dahongx/Oracle-OS/design/references/28ec6939fcf05d6b30dbf5ed5ee75f74.jpg

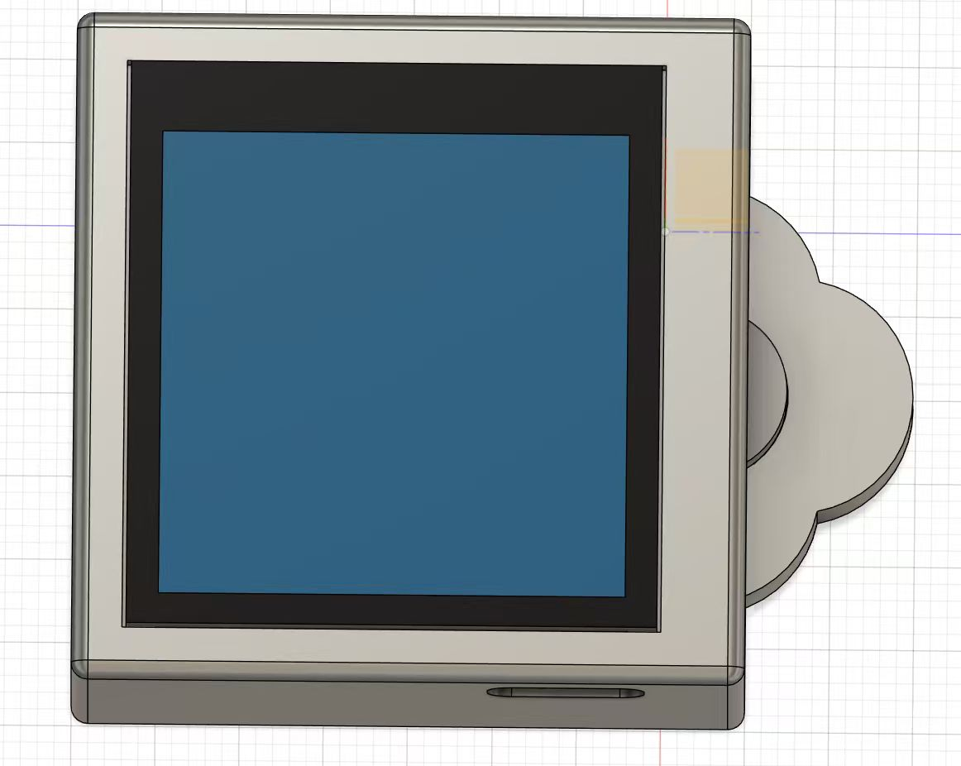
design/references/28ec6939fcf05d6b30dbf5ed5ee75f74.jpg
