dahongx/Oracle-OS/product/ChatGPT Image 2026年7月24日 02_36_47.png

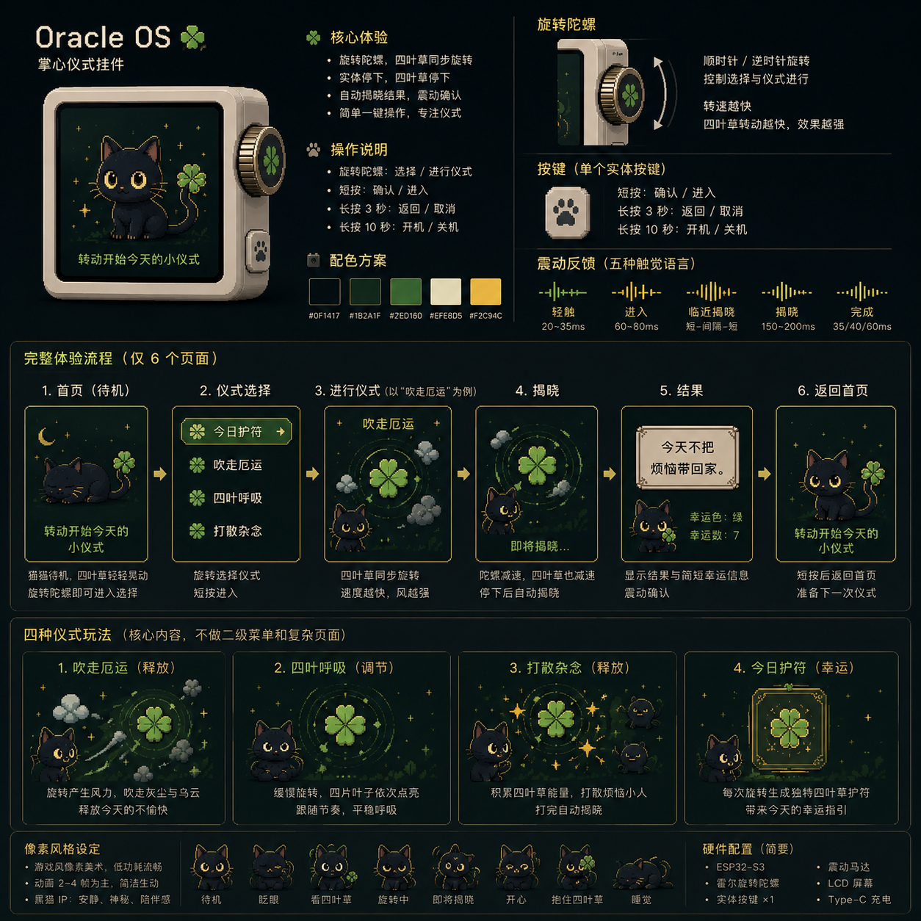
product/ChatGPT Image 2026年7月24日 02_36_47.png
