dahongx/Oracle-OS/design/references/oracle-os-mockup-v1.png

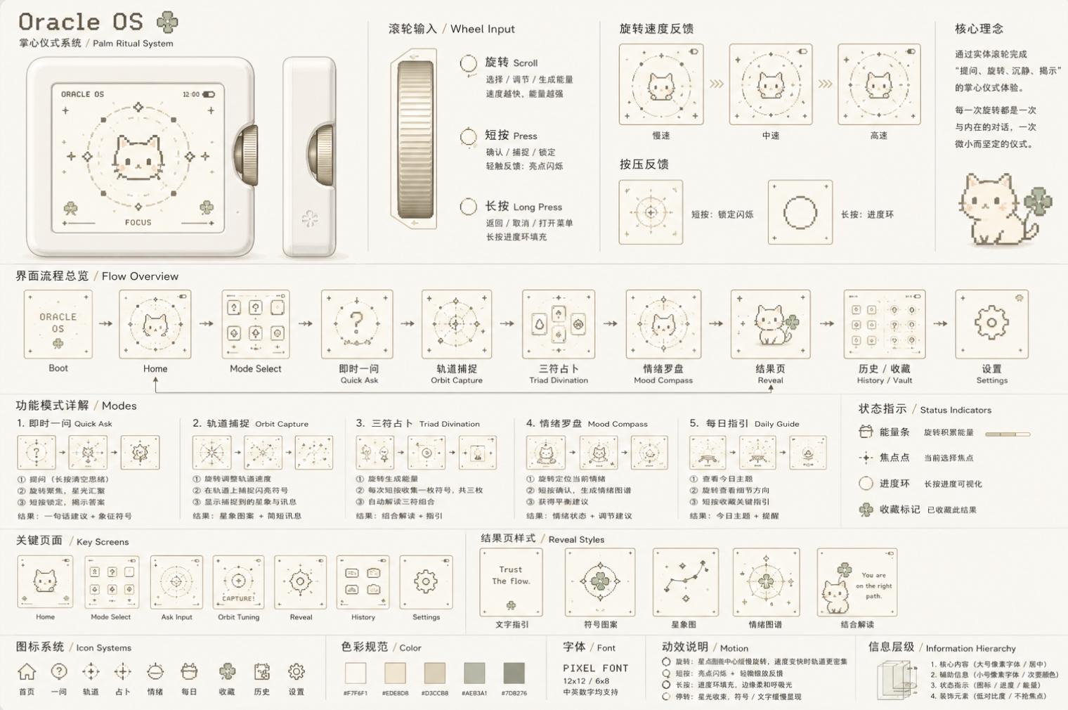
design/references/oracle-os-mockup-v1.png
