dahongx/Oracle-OS/firmware/esp32s3_knob_idf/tools/cat_preview.png

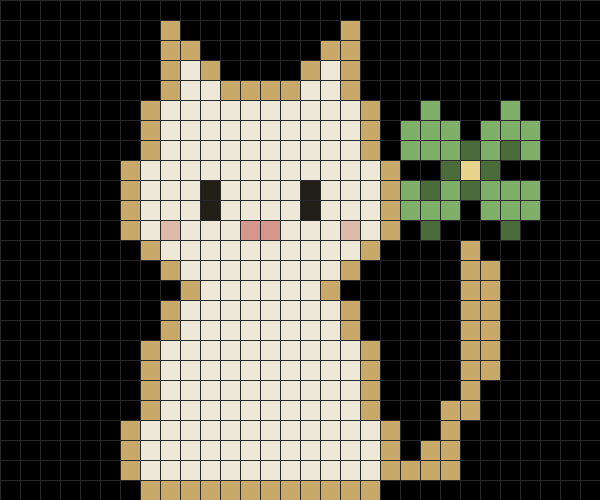
firmware/esp32s3_knob_idf/tools/cat_preview.png
