dahongx/Oracle-OS/firmware/esp32s3_knob_idf/tools/cat_sprites_preview.png

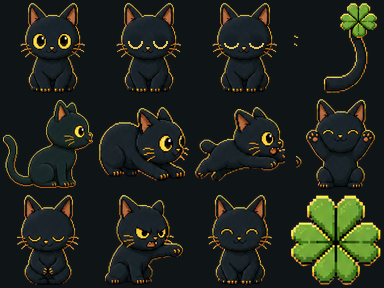
firmware/esp32s3_knob_idf/tools/cat_sprites_preview.png
