dahongx/Oracle-OS/hardware/doc/原理图截图/8ccac7d790108b71e4d9f03ce714a44b.png

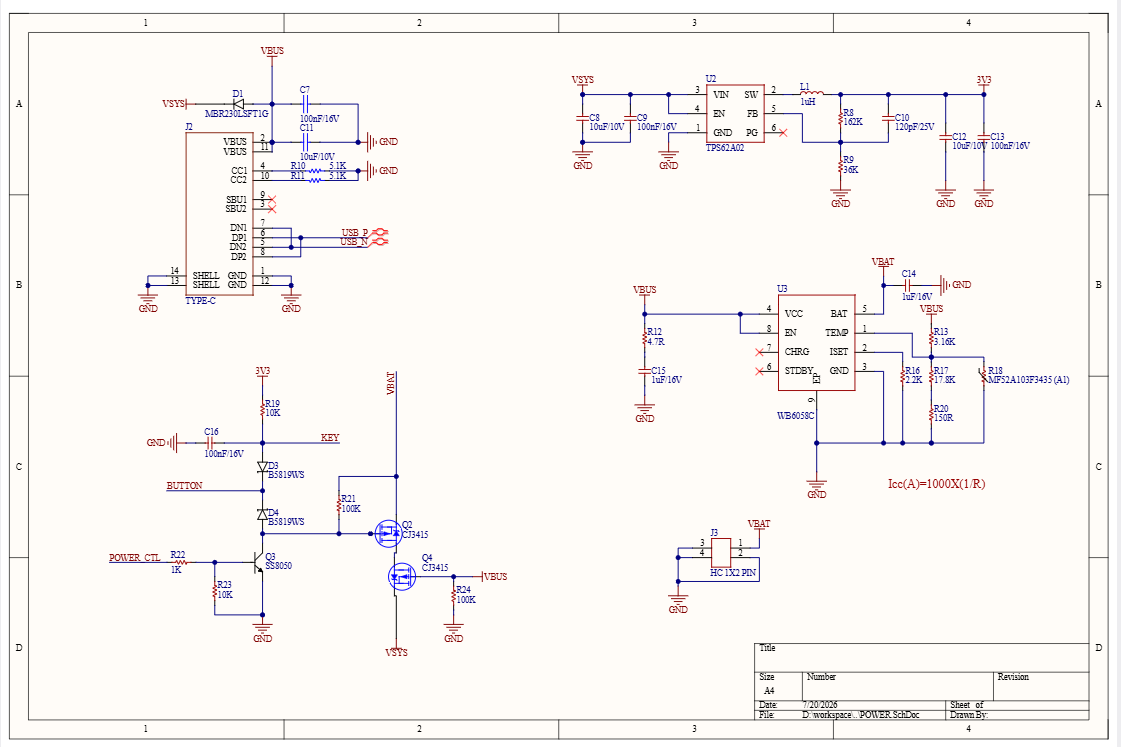
hardware/doc/原理图截图/8ccac7d790108b71e4d9f03ce714a44b.png
