dahongx/Oracle-OS/hardware/doc/原理图截图/cc7f8eec3f1300d87444090f9539df50.png

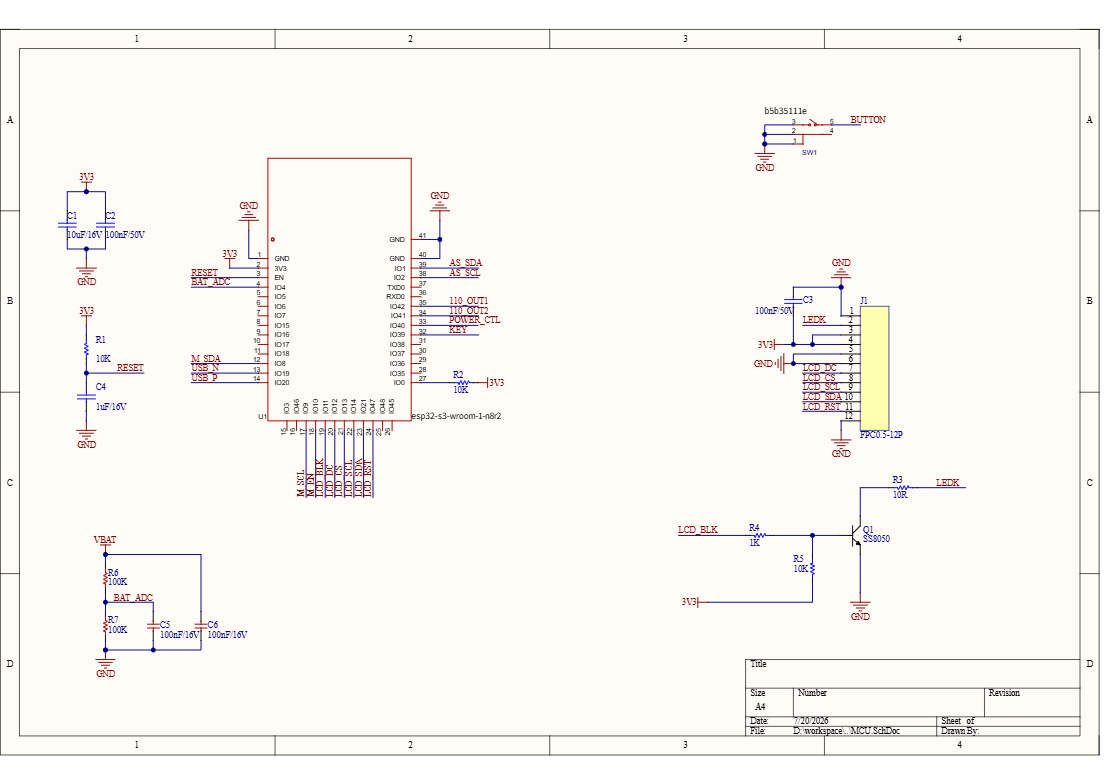
hardware/doc/原理图截图/cc7f8eec3f1300d87444090f9539df50.png
