dahongx/Oracle-OS/hardware/doc/原理图截图/e9339ca9403c0c7844ec5e579f7dc81a.png

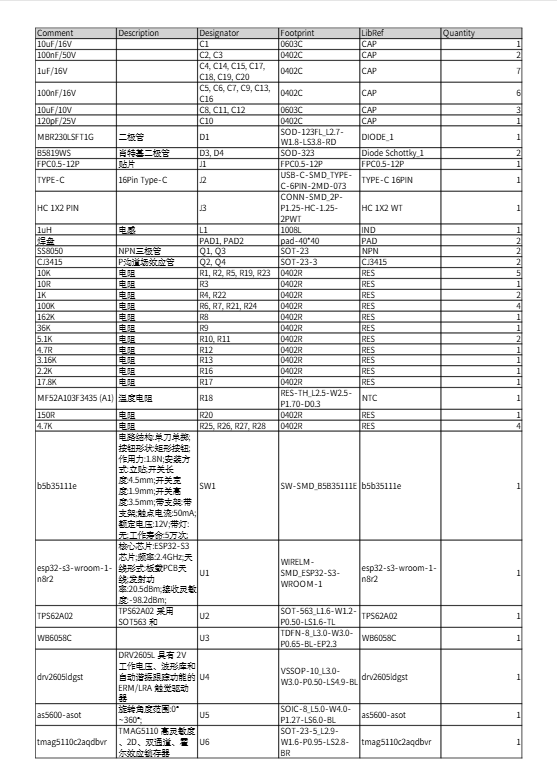
hardware/doc/原理图截图/e9339ca9403c0c7844ec5e579f7dc81a.png
