dahongx/Oracle-OS/hardware/doc/原理图截图/ed22ff82aca11545fae0a07563752018.png

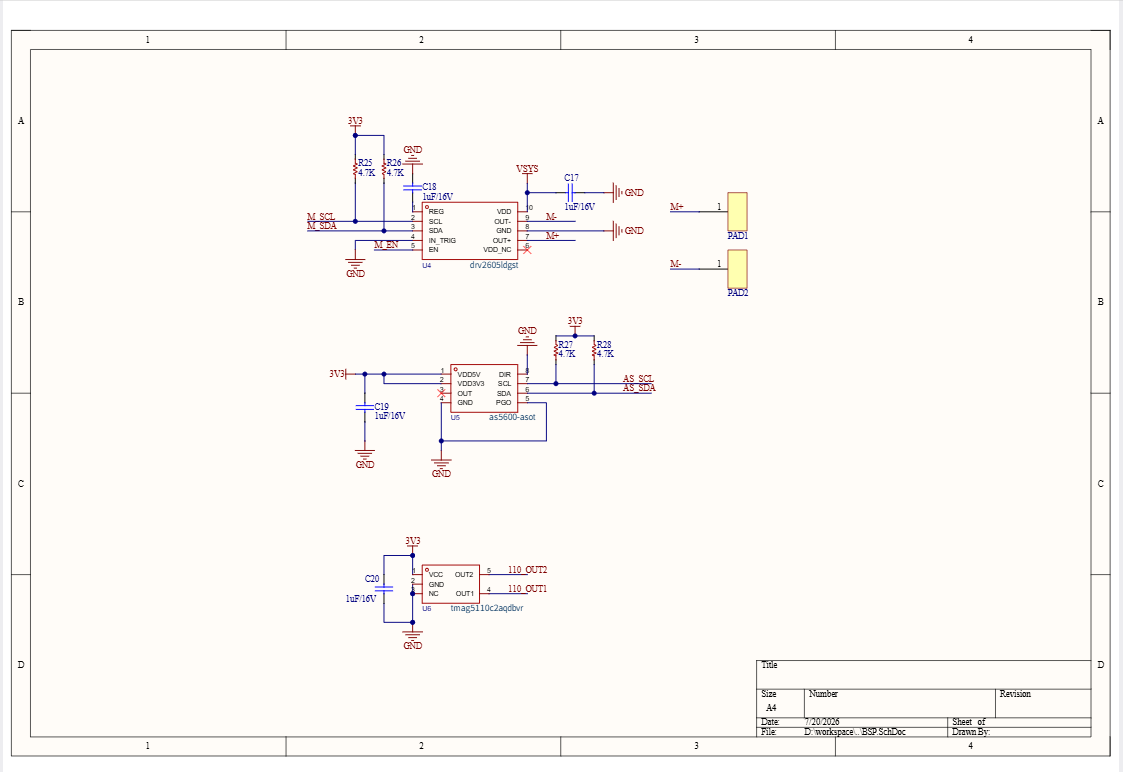
hardware/doc/原理图截图/ed22ff82aca11545fae0a07563752018.png
