dahongx/Oracle-OS/hardware/接口.png

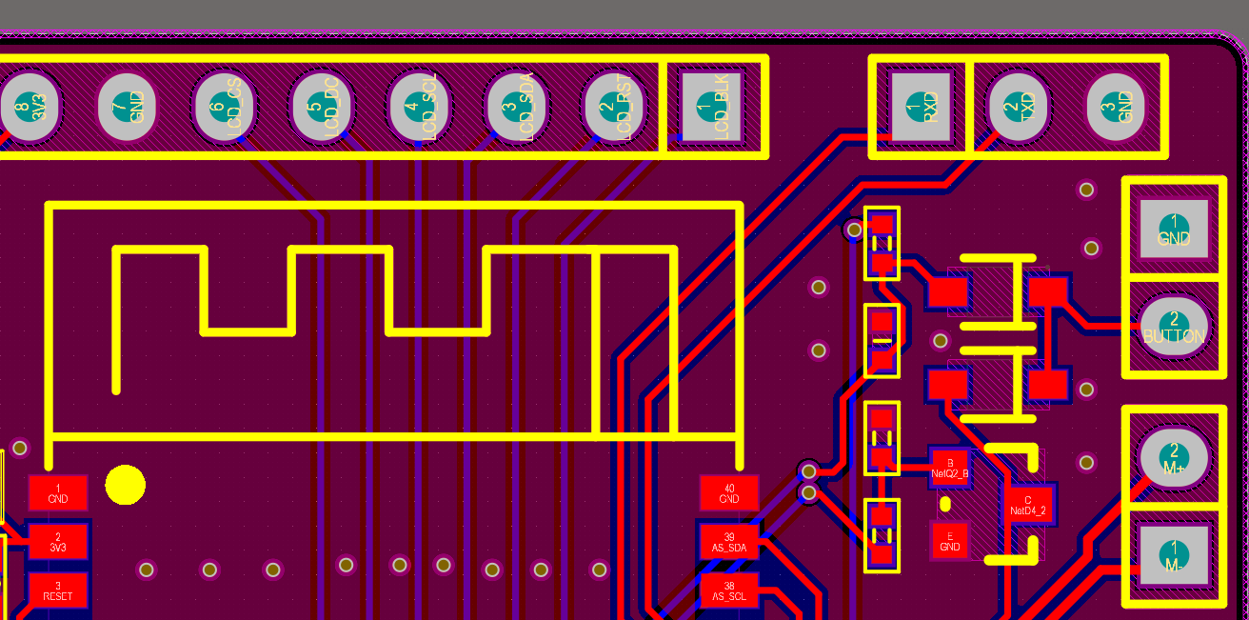
hardware/接口.png
