dahongx/Oracle-OS/product/oracle-cat-ip-sheet-v1.png

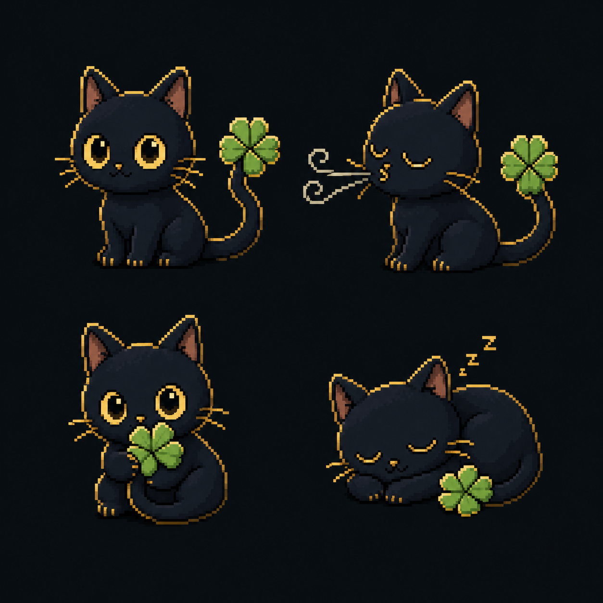
product/oracle-cat-ip-sheet-v1.png
