dahongx/Oracle-OS/product/oracle-cat-ip-sprites-v2.png

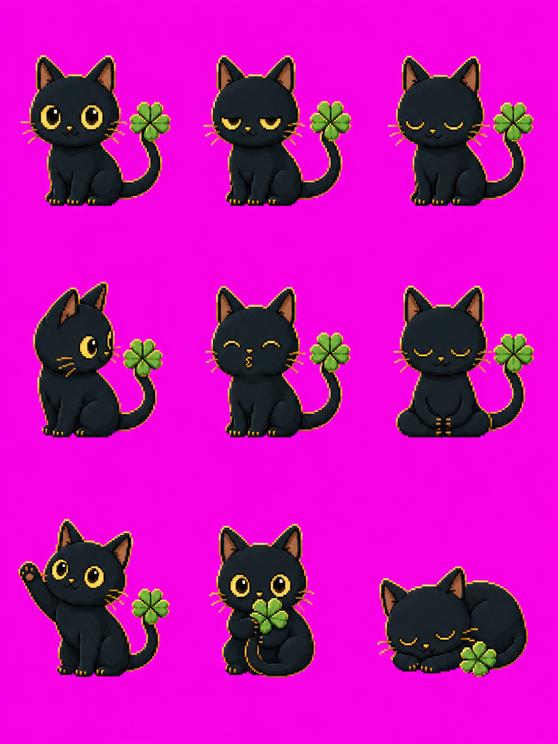
product/oracle-cat-ip-sprites-v2.png
