dahongx/Oracle-OS/product/oracle-cat-ip-sprites-v3-chroma.png

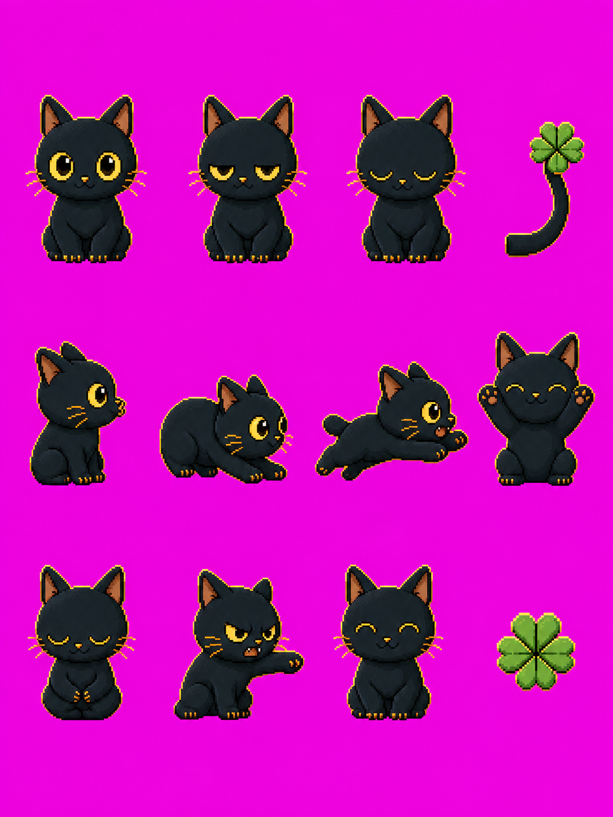
product/oracle-cat-ip-sprites-v3-chroma.png
