dahongx/Oracle-OS/product/oracle-cat-tail-sprites-v4-chroma.png

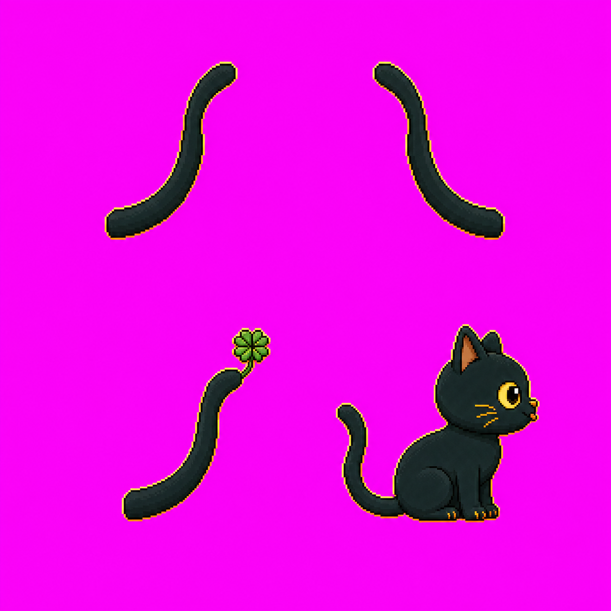
product/oracle-cat-tail-sprites-v4-chroma.png
