dahongx/Oracle-OS/product/Oracle_OS_当前执行任务清单.md

# Oracle OS 当前执行任务清单

---

## ⚠ 本清单是 v1 开发前写的原始规划，部分内容已被实际实现取代

**读之前先看这一节**，否则会按过时的仪式名和参数去做。
下面正文（第 1～22 章）保持原样不改动，作为需求出处保留。

### 仪式名已定案（正文里的旧名作废）

正文写的是 4 个仪式，实际做了 **5 个，统一四个字**：

| 正文里的旧名 | 最终名 | 代码文件 | SceneId |
|---|---|---|---|
| 今日护符 | **今日幸运** | `ui/scenes/daily_scene.hpp` | `DAILY` |
| （新增） | **逗猫时光** | `ui/scenes/play_scene.hpp` | `PLAY` |
| 四叶呼吸 | **四叶呼吸** | `ui/scenes/orbit_scene.hpp` | `ORBIT` |
| 吹走厄运 | **吹走厄运** | `ui/scenes/quick_ask_scene.hpp` | `QUICK_ASK` |
| 打散杂念 | **揍走烦恼** | `ui/scenes/triad_scene.hpp` | `TRIAD` |

> ⚠ 文件名和 `scene.hpp` 里的枚举注释是旧的（`quick_ask`=即时一问、
> `orbit`=轨道捕捉、`triad`=三符占卜），和实际内容对不上，看代码时以上表为准。

「今日幸运」也简化了：正文 §17 那套「4 种叶片 × 4 种中心 × 4 种边框」的护符组合没做，
最终只出**幸运数字 + 幸运色**两项，结果存 NVS，一天内不变。

### 已完成

- §1.1 屏幕参数 —— 定为 **240×240**（正文写的 240×320 会让底部 80px 落到屏外）
- §1.3 按键参数 —— 短按 / 长按 3 秒 / 长按 10 秒都已实现并消抖
- §3 ButtonManager —— `drivers/button_input.hpp`
- §6 开机页 —— `boot_scene.hpp`，约 3.8 秒，无圆圈能量条
- §7 首页 —— `home_scene.hpp`，猫身体固定，只眨眼 + 尾巴轻摆
- §8 仪式选择页 —— `mode_select_scene.hpp`，真实滚动列表
- §11 关机确认页 —— `power_confirm_scene.hpp`，含 USB 供电下的轻睡眠关机
- §13 像素视觉 —— 9 个猫姿态精灵 + Fusion Pixel 中文字模（正文 §13.5 的 12×12 已满足）
- §14～17 五个仪式 —— 首版可玩

### 未完成（正文里仍然有效的部分）

- **§2 RotationManager** —— 现在只有 `KnobService` 的 30° 简单分格。正文要求的
  状态机（IDLE/STARTING/SPINNING/SLOWING/SETTLING/STOPPED/REVEALING/RESULT）、
  转速平滑 A/B 方案对比、停转判断都没做。**旋转组件装上后这是第一优先**。
- **§4 HapticManager** —— `haptic.hpp` 只有 `click/strong/buzz` 三种，
  正文要求的 TICK/ENTER/REVEAL/CANCEL/POWER 五种语义波形没做，
  而且 `play_openloop()` 是阻塞的，正文 §4 要求的非阻塞管理器待做。
- **§12 低电量 / 充电页** —— 未实现（`SceneId` 里也还没有这两个）
- §1.2 旋转硬件参数采集 —— 旋转组件未安装，AS5600 在新板上持续 NACK
- §18 功耗与休眠 —— 30～60 秒降亮度、2～5 分钟睡眠动画都未做
- §19 异常处理 —— 霍尔异常提示、数据跳变过滤未做
- §20 测试任务 —— 未系统执行
- §21 排期 —— 已不适用，仅作参考

### 当前临时输入方案

旋转组件尚未安装（`app_main.cpp` 里 `ROTARY_INSTALLED = false`），
所以正文各章写的「旋转选择」暂时由单键代替：

| 操作 | 当前含义 |
|---|---|
| 短按 | 下一项 / 给仪式注入一次能量 |
| 双击 | 进入 / 确认 |
| 长按 3 秒 | 返回 |
| 长按 10 秒 | 关机确认（首页） |

装上旋转件后把 `ROTARY_INSTALLED` 改成 `true`，即恢复正文描述的
「旋转选择、短按进入、长按返回」，页面逻辑不用改。

---

## 1. 规格确认

### 1.1 屏幕参数

- 确认实际分辨率、屏幕方向、色深和刷新方式
- 确认 SPI 稳定频率、可视区域与安全边距
- 输出 1:1 像素设计画布
- 输出屏幕安全区标注图

### 1.2 旋转硬件参数

- 读取霍尔传感器原始角度
- 分别记录顺时针、逆时针、慢速、中速、高速旋转数据
- 记录自然减速、突然停止、轻微晃动与机械抖动数据
- 确认采样频率
- 确认实体转动与传感器角度的对应关系
- 输出原始数据日志

### 1.3 按键参数

- 确认短按触发时长
- 确认长按 3 秒返回
- 确认长按 10 秒开关机
- 确认按键消抖时间
- 确认长按视觉进度反馈方式

### 1.4 振动参数

- 确认振动马达型号与 DRV2605L 可用波形
- 确认最短稳定振动时长和强度范围
- 检查振动是否影响霍尔数据
- 检查完整装配后是否出现外壳异响

---

## 2. 旋转输入模块

建立统一的 `RotationManager`。

### 2.1 输出数据

- 原始角度
- 标准化角度
- 当前帧角度差
- 顺时针或逆时针
- 瞬时转速
- 平滑转速
- 最大转速
- 平均转速
- 旋转持续时间
- 方向切换次数
- 最终停转角度

### 2.2 角度环绕处理

正确处理：

- `359° → 2°`
- `2° → 359°`

避免误判为大角度反向跳变。

### 2.3 转速平滑

先实现并比较两套方案：

#### 方案 A：移动平均

- 使用最近 4～8 帧数据

#### 方案 B：指数平滑

```text
smoothSpeed =
previousSmoothSpeed × 0.7
+ currentSpeed × 0.3
```

### 2.4 旋转状态机

```text
IDLE
STARTING
SPINNING
SLOWING
SETTLING
STOPPED
REVEALING
RESULT
```

### 2.5 停转判断

初始建议：

```text
平滑转速低于停止阈值
并持续 400～700ms
且期间累计角度变化小于容差
→ 确认停转
```

若 `SETTLING` 期间重新发生有效旋转：

```text
SETTLING → SPINNING
```

### 2.6 统一事件

向上层输出：

```text
ROTATE_START
ROTATE_UPDATE
ROTATE_SLOWING
ROTATE_SETTLING
ROTATE_STOP
ROTATE_CW
ROTATE_CCW
```

事件携带：

- 当前角度
- 当前速度
- 平滑速度
- 方向
- 持续时间
- 累计角度
- 本次统计数据

### 2.7 四叶草同步

先用临时四叶草图测试：

- 低速：接近实体角度同步
- 中速：角度同步加插值
- 高速：切换为 4 帧或 8 帧旋转动画
- 减速：逐步回到实际角度
- 停止：锁定最终角度

### 2.8 验收

- 实体开始转动后 100ms 内有屏幕响应
- 高速时不闪烁、不倒转
- 减速连续
- 停止后约 150ms 完成画面锁定
- 连续 100 次停转测试中误提前揭晓不超过 2 次
- 停止后 1 秒内完成识别
- 轻微碰撞不会重复揭晓

---

## 3. 按键输入模块

建立统一的 `ButtonManager`。

### 3.1 输出事件

```text
BUTTON_DOWN
BUTTON_UP
BUTTON_SHORT
BUTTON_LONG_3S
BUTTON_LONG_10S
```

### 3.2 时长规则

#### 短按

```text
50ms～800ms
```

用途：

- 确认
- 进入
- 结果页返回首页
- 关机确认

#### 长按 3 秒

用途：

- 返回
- 取消
- 从仪式选择页返回首页
- 在关机确认页取消

#### 长按 10 秒

用途：

- 开机
- 从首页进入关机确认

### 3.3 消抖

- 按键状态稳定 20～40ms 后再确认
- 防止一次按压触发多次事件

### 3.4 长按视觉反馈

- 四叶草外圈逐步闭合
- 3 秒返回：3 秒内完成一圈
- 10 秒关机：10 秒内完成一圈
- 达到触发阈值时轻震一次

### 3.5 验收

- 短按 100 次无重复触发
- 3 秒长按 50 次正确返回
- 10 秒长按 30 次正确进入关机确认
- 2.5 秒按压不误触发返回
- 9 秒按压不误触发关机

---

## 4. 振动反馈模块

建立统一的 `HapticManager`。

### 4.1 反馈类型

```text
TICK
ENTER
REVEAL
CANCEL
POWER
```

### 4.2 初始波形

#### TICK

- 20～35ms
- 很低强度
- 模式选择跨越一个选项时触发

#### ENTER

- 60～80ms
- 中低强度
- 进入仪式时触发

#### REVEAL

- 150～200ms
- 中等强度
- 停转后结果锁定时触发

#### CANCEL

- 60ms
- 间隔 50ms
- 再 60ms
- 返回或取消时触发

#### POWER

- 100ms
- 间隔 80ms
- 再 180ms
- 关机确认时触发

### 4.3 震动实验室

工程调试页面：

```text
1. TICK
2. ENTER
3. REVEAL
4. CANCEL
5. POWER
```

操作：

- 旋转选择
- 短按播放

测试：

- 手持
- 桌面
- 挂绳悬挂
- 完整装配
- 满电
- 低电量

### 4.4 验收

- 各反馈可明显区分
- 揭晓反馈最明确
- 不干扰陀螺自然停转
- 不造成霍尔数据异常
- 外壳无明显异响
- 低电量下稳定工作

---

## 5. 系统页面状态

```text
BOOT
HOME
RITUAL_SELECT
RITUAL_ACTIVE
RITUAL_SETTLING
RITUAL_REVEAL
RESULT
POWER_CONFIRM
LOW_BATTERY
CHARGING
ERROR
```

建立统一 `ScreenManager` 或 `AppStateMachine`。

---

## 6. 开机页面

### 内容

1. 深色背景
2. 中央四叶草出现
3. 四片叶子依次点亮
4. 黑猫探头或睁眼
5. 显示 `ORACLE OS`
6. 自动进入首页

### 时长

- 1.5～2.5 秒

### 验收

- 无卡顿
- 总时长不超过 3 秒
- 动画结束后稳定进入首页
- 低电量时可转入低电提示

---

## 7. 首页

### 结构

- 中央：像素黑猫
- 猫尾巴末端：四叶草
- 底部：`转动开始`
- 电量保留必要图标

### 状态

#### 正常待机

- 猫坐着
- 偶尔眨眼
- 四叶草轻微摆动

#### 长时间无操作

- 猫趴下睡觉
- 屏幕亮度降低

#### 检测到轻微旋转

- 猫睁眼
- 看向尾巴
- 四叶草开始同步旋转

#### 达到有效唤醒阈值

- 进入仪式选择页

### 美术输出

- 待机姿态
- 睡觉姿态
- 睁眼姿态
- 看向四叶草姿态
- 旋转响应姿态

---

## 8. 仪式选择页

### 结构

```text
选择仪式

今日护符
吹走厄运
四叶呼吸
打散杂念
```

### 当前项

- 高亮背景
- 左侧小四叶草
- 当前项亮度更高
- 其他项降低亮度

### 操作

- 旋转：移动焦点
- 短按：进入
- 长按 3 秒：返回首页

### 列表规则

- 累计旋转达到一个角度阈值后移动一项
- 移动后重置累计角度
- 每移动一项播放 `TICK`
- 最大切换频率建议每 120ms 一项

### 验收

- 慢转可逐项选择
- 快转不会瞬间跳过全部选项
- 焦点清晰
- 短按进入正确仪式

---

## 9. 通用仪式进行页

### 布局

- 顶部：仪式名称
- 中央：四叶草或主要对象
- 角落：黑猫
- 底部：一句状态提示

### 状态

#### 等待开始

- 四叶草静止
- 猫看向四叶草
- 提示：`转动开始`

#### 旋转中

- 四叶草同步旋转
- 游戏效果随转速变化
- 猫进入专注姿态

#### 减速中

- 四叶草逐渐减速
- 游戏效果逐渐收束
- 猫进入等待状态

#### 即将停转

- 四叶草接近静止
- 提示：`快停下了`

#### 停转完成

- 四叶草锁定
- 停顿 150～300ms
- 播放 `REVEAL`
- 执行 2～4 帧揭晓动画

---

## 10. 结果页

### 结构

- 中央或上部：一句结果文案
- 下部：猫猫与停止的四叶草
- 可附带一个极简辅助信息

示例：

```text
今天不把
烦恼带回家。
```

辅助信息：

```text
幸运色：绿
```

### 操作

- 短按：返回首页
- 长按 3 秒：返回首页

### 验收

- 结果一眼可读
- 文案最多 2～3 行
- 不重复震动
- 返回后首页状态正确复位

---

## 11. 关机确认页

### 进入

- 首页长按 10 秒

### 内容

```text
要休息了吗？

短按关机
长按取消
```

### 配图

- 猫猫抱住尾巴或趴下
- 四叶草停止发光

### 操作

- 短按：确认关机
- 长按 3 秒：取消并返回首页

### 关机流程

1. 播放 `POWER`
2. 保存必要状态
3. 播放猫猫睡觉动画
4. 关闭背光
5. 进入关机或深度睡眠

---

## 12. 低电量与充电页面

### 低电量

```text
电量有点低
```

低于安全阈值：

```text
先休息一下
```

流程：

1. 显示提示
2. 保存必要状态
3. 播放睡觉动画
4. 关闭屏幕
5. 安全关机

### 充电

- 猫猫睡觉
- 四叶草叶片依次点亮
- 显示电池图标
- 电量准确时显示百分比

---

## 13. 像素视觉制作

### 13.1 像素网格

- 按真实分辨率设计
- 输出 1× 原始稿
- 输出 4× 或 8× 预览稿
- 使用最近邻缩放
- 禁用双线性过滤
- 使用整数像素坐标

### 13.2 配色

- 背景：`#0F1417`
- 深森林绿：`#1B2A1F`
- 主幸运绿：`#4F8B46`
- 亮幸运绿：`#8FCB75`
- 米白文字：`#EFE8D5`
- 暖黄色高光：`#E7C35A`
- 猫毛深蓝黑：`#12171C`
- 猫眼暖灰黄：`#D7BE75`

### 13.3 黑猫动作

每组 2～4 帧：

1. 坐姿待机
2. 眨眼
3. 睡觉
4. 看向四叶草
5. 旋转中
6. 即将揭晓
7. 轻轻点头
8. 抱住四叶草
9. 关机睡觉

### 13.4 四叶草动画

1. 静止
2. 低速旋转
3. 中速旋转
4. 高速旋转
5. 减速
6. 发光
7. 停止锁定
8. 护符形态

### 13.5 字体

- 中文正文字模不小于 12×12
- 重要结果使用 16×16 或更大
- 每屏结果控制在 8～16 个汉字
- 最多 2～3 行
- 使用清晰像素字体

---

## 14. 第一款仪式：吹走厄运

### 14.1 流程

```text
进入仪式
→ 用户转动
→ 四叶草同步旋转
→ 产生风
→ 灰尘与乌云逐渐消失
→ 用户停止
→ 四叶草停止
→ 震动
→ 自动揭晓
→ 显示结果
→ 短按返回首页
```

### 14.2 灰盒原型

制作：

- 一个四叶草
- 3～6 个灰点
- 1～2 个云块
- 2 条风线
- 一个猫轮廓

验证：

- 转速与风速关系
- 粒子移动
- 停转识别
- 自动揭晓
- 震动时机

### 14.3 转速映射

#### 低速

- 四叶草缓慢旋转
- 风线少
- 灰尘缓慢移动

#### 中速

- 风线增多
- 灰尘明显向外移动
- 乌云逐渐变淡

#### 高速

- 四叶草进入高速动画
- 粒子快速消散
- 猫进入专注姿态

### 14.4 最低有效条件

- 累计旋转超过指定角度
- 或持续旋转 2～3 秒

若条件不足：

```text
再转一下
```

### 14.5 停转收尾

1. 实体减速
2. 四叶草减速
3. 风线减少
4. 剩余灰尘慢慢飘走
5. 停顿 150～300ms
6. 播放 `REVEAL`
7. 猫点头
8. 结果文案出现

揭晓总时长：0.8～1.5 秒。

### 14.6 结果规则

根据：

- 旋转时长
- 平均速度
- 转速稳定度
- 停转方式
- 顺时针或逆时针
- 方向变化次数

### 14.7 文案池

首版准备 20～30 条。

示例：

- 慢一点也没关系。
- 今天先给自己留一点空白。
- 不把烦恼带回家。
- 已经吹远了，先别回头看。
- 不用现在就想明白。
- 换个方向，也算继续前进。
- 先停在这里。
- 今天做到这里就够了。

### 14.8 验收

邀请至少 10 名非项目人员体验，记录：

- 是否知道要转
- 是否理解四叶草与实体同步
- 是否理解停下后自动揭晓
- 是否误以为需要按键停止
- 震动时机是否自然
- 是否能在 45 秒内完成
- 是否发生误揭晓
- 是否发生重复揭晓

---

## 15. 第二款仪式：四叶呼吸

### 页面

- 中央大四叶草
- 猫猫闭眼呼吸
- 底部：`慢慢转`

### 玩法

- 四片叶子随角度依次点亮
- 一圈形成一个完整节奏
- 完成 3 圈后结束
- 每圈完成轻震一次
- 最终完成时播放明确震动

### 实现

- 低速角度识别
- 圈数统计
- 叶片点亮顺序
- 方向变化处理
- 过快提示
- 完成逻辑

过快时：

```text
慢一点
```

### 文案

- 现在不用急。
- 把呼吸留在这里。
- 慢下来，也是一种前进。

---

## 16. 第三款仪式：打散杂念

### 页面对象

- 黑色毛球
- 噪点团
- 皱纸怪
- 小乌云
- 乱线结

### 流程

```text
开始旋转
→ 积累四叶草能量
→ 杂念团逐渐抖动
→ 实体停转
→ 四叶草自动释放
→ 杂念团散开
→ 震动
→ 显示结果
```

### 能量输入

- 累计转动角度
- 平均速度
- 持续时间

能量不足时：

```text
还差一点
```

### 文案

- 先把这件事放远一点。
- 杂念散了，今天到这里。
- 它不值得一直占着你的脑子。

---

## 17. 第四款仪式：今日护符

### 输入

- 转动时长
- 平均速度
- 最大速度
- 稳定度
- 方向
- 方向变化
- 停转方式

### 护符组件

- 4 种叶片形状
- 4 种中心图案
- 4 种边框
- 4 种光点
- 3 种主色

### 结果页

展示：

- 护符大图
- 护符名称
- 一句提示

示例：

```text
缓慢之叶

今天不用
马上给出答案。
```

### 返回

- 短按返回首页
- 长按 3 秒返回首页

---

## 18. 性能与功耗

### 帧率

- 普通页面 20～30 FPS
- 高速四叶草使用离散动画帧
- 输入采样与屏幕刷新解耦
- 动画不得阻塞传感器采样

### 主循环任务

- 输入采样任务
- 页面逻辑任务
- 动画更新任务
- 屏幕刷新任务
- 振动任务
- 电源任务

### 资源统计

- 像素图占用
- 动画占用
- 中文字库大小
- 缓冲区占用
- 固件大小
- RAM 峰值

### 休眠

- 30～60 秒无操作：降低亮度
- 2～5 分钟无操作：进入睡眠动画
- 更长时间：关闭背光或进入低功耗
- 检测旋转或按键后唤醒

---

## 19. 异常处理

### 霍尔异常

```text
四叶草有点晕
请再试一次
```

### 数据跳变

- 忽略超过物理可能范围的角度变化
- 记录异常计数

### 按键卡住

- 超过合理按压时长后进入安全处理
- 防止持续重复触发

### 低电关机

- 保存必要状态
- 关闭背光
- 安全关机

### 振动异常

- 振动失败不能阻塞揭晓流程

---

## 20. 测试任务

### 20.1 旋转

- 顺时针慢转 50 次
- 顺时针快转 50 次
- 逆时针慢转 50 次
- 逆时针快转 50 次
- 来回切换方向 50 次
- 自然停转 100 次
- 突然停止 50 次
- 停转后轻碰 50 次
- 低电量状态旋转 30 次

记录：

- 起转识别
- 方向识别
- 停转延迟
- 误揭晓
- 重复揭晓
- 四叶草抖动

### 20.2 按键

- 短按 100 次
- 1 秒按压 30 次
- 2.5 秒按压 30 次
- 3 秒按压 50 次
- 9 秒按压 20 次
- 10 秒按压 30 次
- 连续快速短按 50 次
- 关机确认取消 30 次

### 20.3 振动

测试：

- 手持
- 桌面
- 挂绳悬挂
- 完整装配
- 满电
- 低电

观察：

- 震感强度
- 异响
- 对陀螺的干扰
- 对霍尔数据的影响
- 各反馈是否可区分

### 20.4 UI

实机检查：

- 中文清晰度
- 黑猫识别度
- 四叶草识别度
- 当前焦点
- 结果文案
- 强光环境
- 暗光环境

### 20.5 无指导用户测试

邀请 10～20 名目标用户，观察：

- 是否主动转动
- 是否会旋转选择
- 是否会短按进入
- 是否理解停转自动揭晓
- 是否认为震动时机自然
- 是否能独立完成一次仪式

目标：

```text
80% 以上用户无需讲解即可完成一次完整仪式
```

---

## 21. 建议排期

### 第 1 周

- 确认屏幕参数
- 采集霍尔原始数据
- 完成按键读取
- 完成振动驱动
- 输出硬件参数表

### 第 2 周

- 角度环绕
- 方向判断
- 转速计算
- 平滑算法
- 状态机
- 停转判断
- 四叶草同步 Demo

### 第 3 周

- 短按
- 3 秒长按
- 10 秒长按
- 长按视觉反馈
- 振动词典
- 振动实验室

### 第 4 周

- 开机
- 首页
- 仪式选择
- 通用仪式页
- 揭晓
- 结果页
- 关机确认
- 低电量
- 充电

### 第 5 周

- 黑猫基础造型
- 尾巴四叶草
- 待机动画
- 睡觉动画
- 旋转响应
- 揭晓动作
- 正式字体与配色

### 第 6 周

- 吹走厄运灰盒
- 转速映射
- 粒子
- 停转收尾
- 振动
- 结果文案
- 用户测试

### 第 7 周

- 四叶呼吸
- 打散杂念
- 今日护符

### 第 8 周

- 动画节奏
- 振动调校
- 功耗
- 异常处理
- 文案统一
- 稳定性测试
- 用户测试

---

## 22. 当前立即执行

1. 确认屏幕分辨率、色深、刷新方式和安全区域
2. 输出霍尔传感器原始角度日志
3. 实现 0° / 360° 角度环绕修正
4. 实现方向与转速计算
5. 实现最小旋转状态机：

```text
IDLE
SPINNING
SETTLING
STOPPED
```

6. 在屏幕显示临时四叶草，并与实体旋转同步
7. 实现短按、3 秒长按、10 秒长按
8. 制作 5 种振动波形测试程序
9. 按真实屏幕尺寸输出首页三态：
   - 睡觉
   - 唤醒
   - 旋转响应
10. 在实机确定最自然的停转识别和揭晓时机
