dahongx/Oracle-OS/oracle_os_web_checked(1)/verified_preview.png

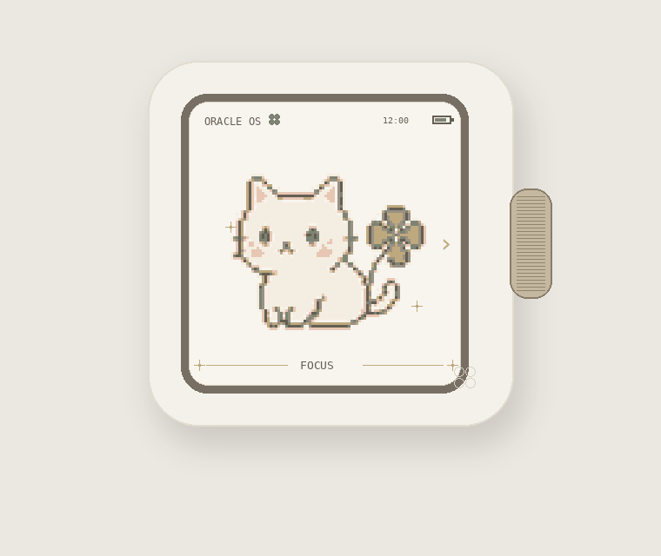
oracle_os_web_checked(1)/verified_preview.png
