dahongx/Oracle-OS/hardware/doc/Oracle OS.pdf

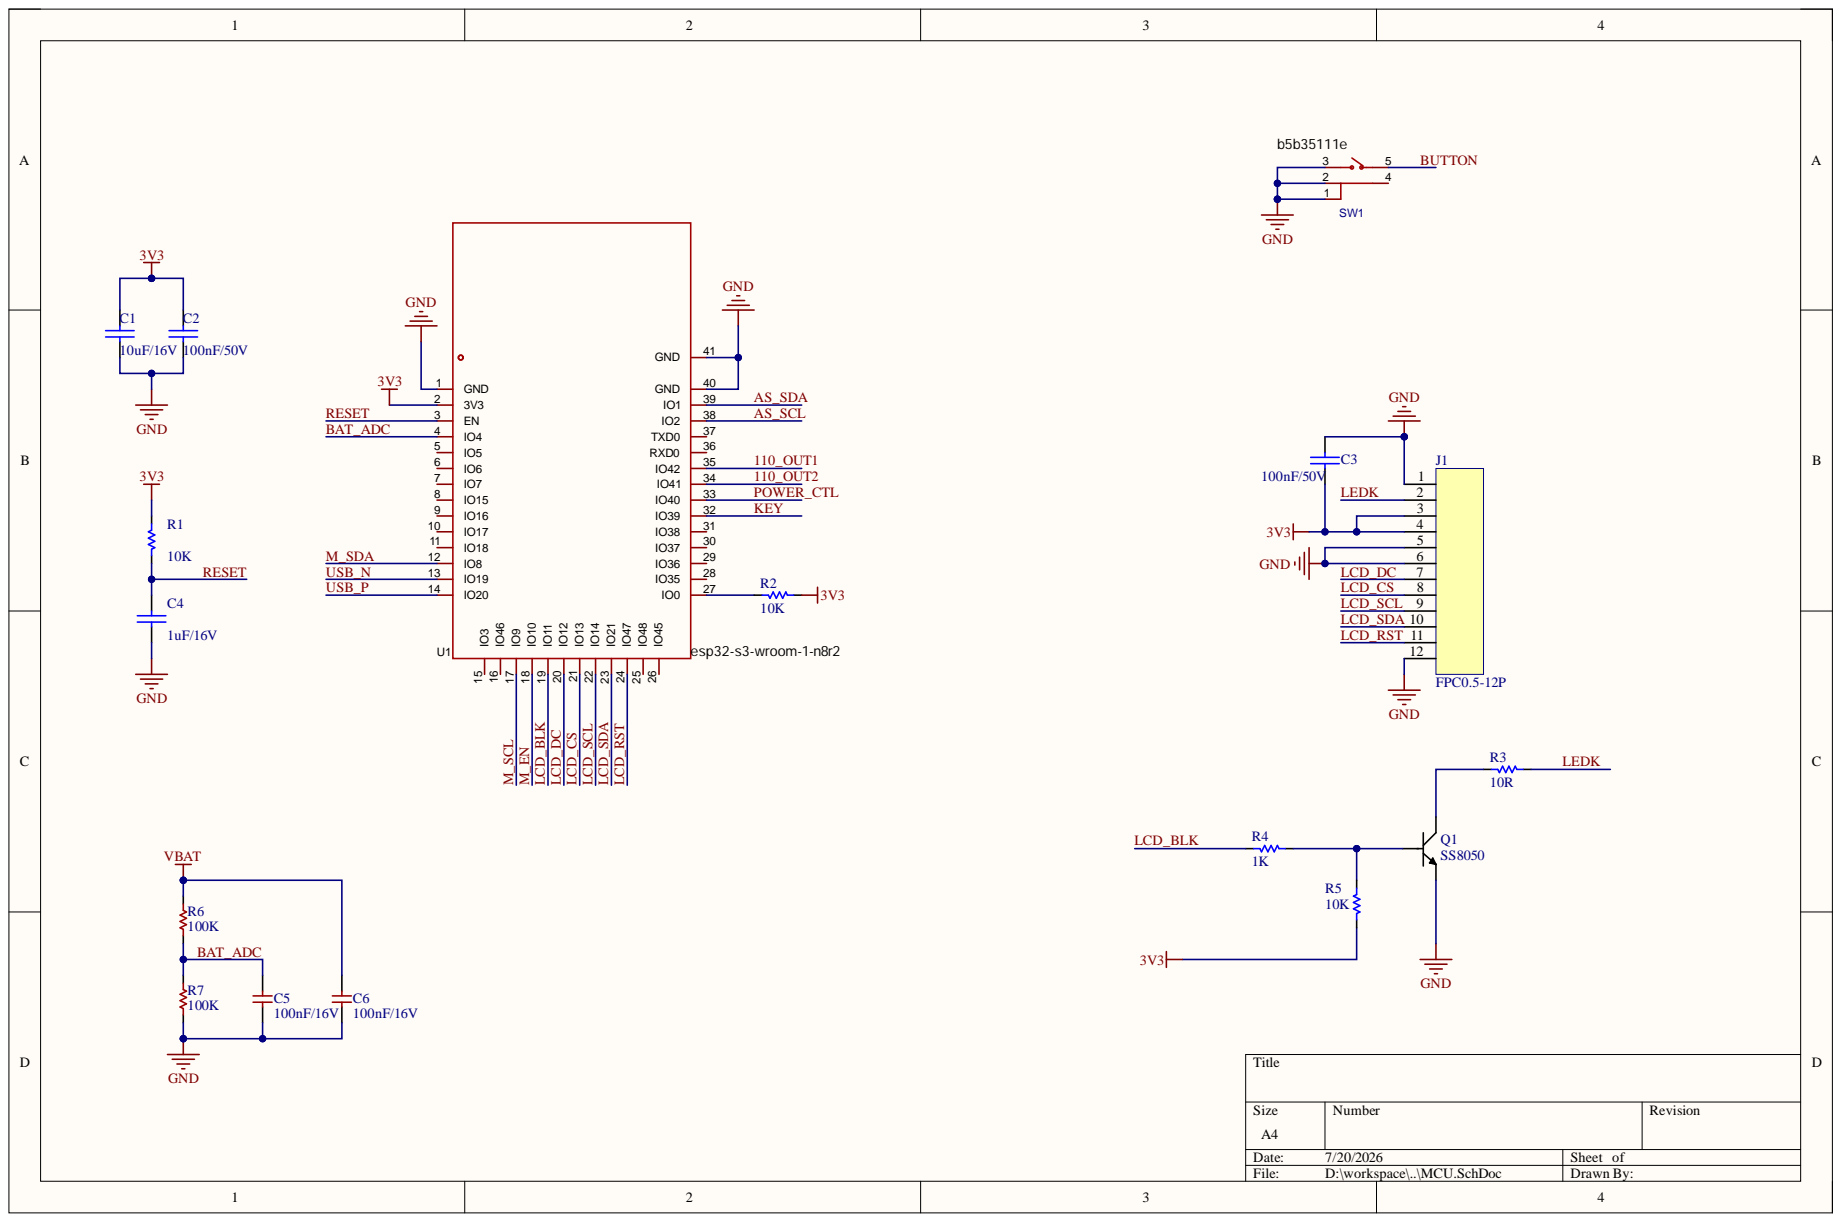
[picture p16: page 1]

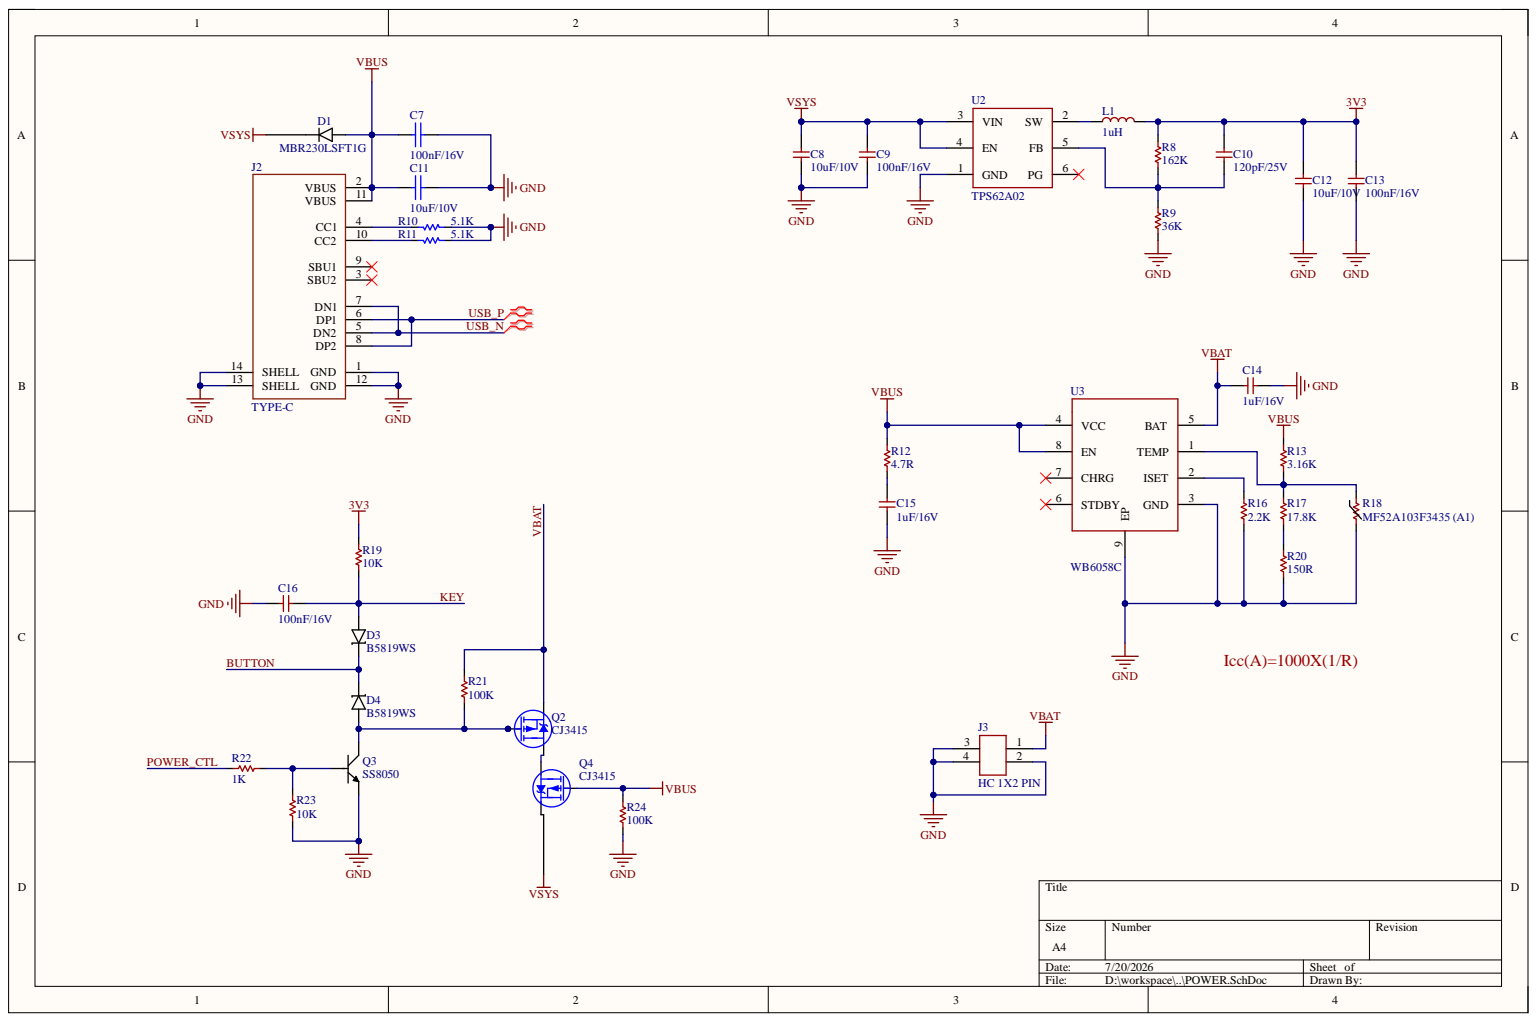
[picture p17: page 2]

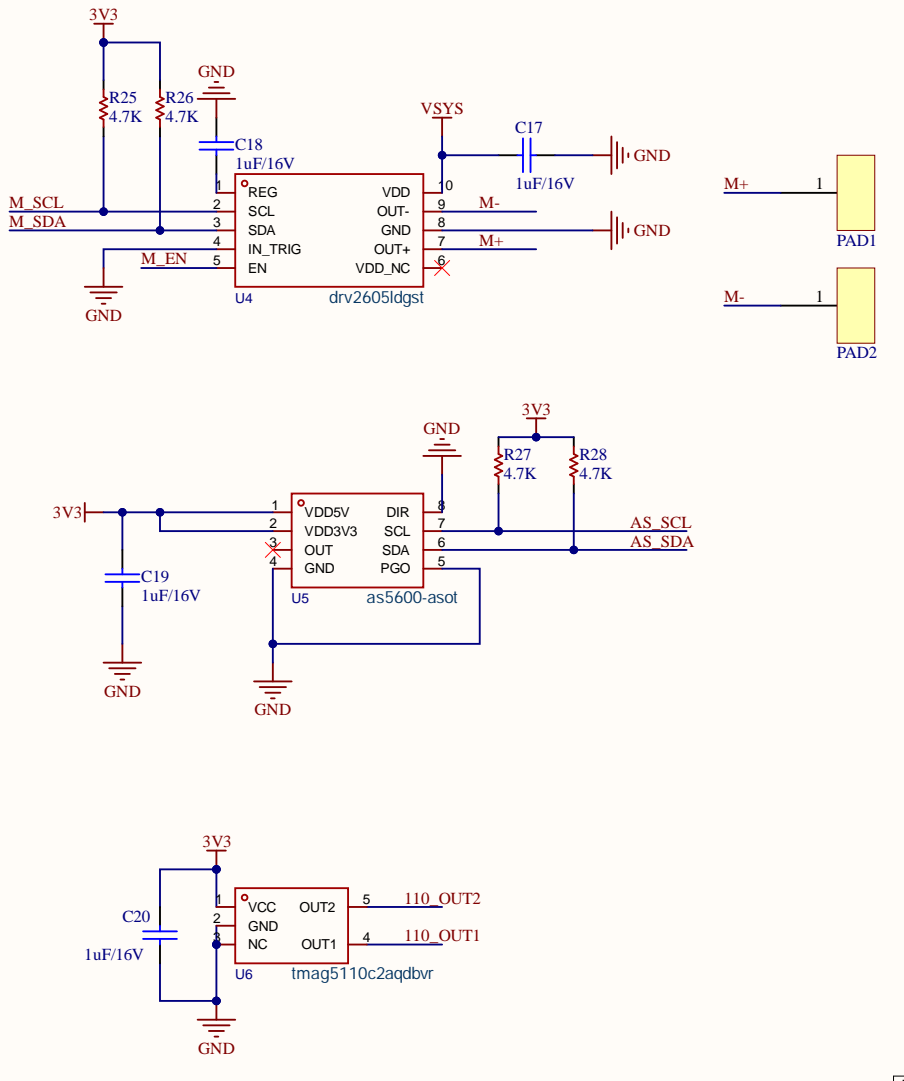
[picture p18: page 3]

Comment | Description | Designator | Footprint | LibRef | Quantity
10uF/16V | | C1 | 0603C | CAP | 1
100nF/50V | | C2, C3 | 0402C | CAP | 2
1uF/16V | | C4, C14, C15, C17, C18, C19, C20 | 0402C | CAP | 7
100nF/16V | | C5, C6, C7, C9, C13, C16 | 0402C | CAP | 6
10uF/10V | | C8, C11, C12 | 0603C | CAP | 3
120pF/25V | | C10 | 0402C | CAP | 1
MBR230LSFT1G | 二极管 | D1 | SOD-123FL_L2.7-W1.8-LS3.8-RD | DIODE_1 | 1
B5819WS | 肖特基二极管 | D3, D4 | SOD-323 | Diode Schottky_1 | 2
FPC0.5-12P | 贴片 | J1 | FPC0.5-12P | FPC0.5-12P | 1
TYPE-C | 16Pin Type-C | J2 | USB-C-SMD_TYPE-C-6PIN-2MD-073 | TYPE-C 16PIN | 1
HC 1X2 PIN | | J3 | CONN-SMD_2P-P1.25-HC-1.25-2PWT | HC 1X2 WT | 1
1uH | 电感 | L1 | 1008L | IND | 1
焊盘 | | PAD1, PAD2 | pad-40*40 | PAD | 2
SS8050 | NPN三极管 | Q1, Q3 | SOT-23 | NPN | 2
CJ3415 | P沟道场效应管 | Q2, Q4 | SOT-23-3 | CJ3415 | 2
10K | 电阻 | R1, R2, R5, R19, R23 | 0402R | RES | 5
10R | 电阻 | R3 | 0402R | RES | 1
1K | 电阻 | R4, R22 | 0402R | RES | 2
100K | 电阻 | R6, R7, R21, R24 | 0402R | RES | 4
162K | 电阻 | R8 | 0402R | RES | 1
36K | 电阻 | R9 | 0402R | RES | 1
5.1K | 电阻 | R10, R11 | 0402R | RES | 2
4.7R | 电阻 | R12 | 0402R | RES | 1
3.16K | 电阻 | R13 | 0402R | RES | 1
2.2K | 电阻 | R16 | 0402R | RES | 1
17.8K | 电阻 | R17 | 0402R | RES | 1
MF52A103F3435 (A1) | 温度电阻 | R18 | RES-TH_L2.5-W2.5-P1.70-D0.3 | NTC | 1
150R | 电阻 | R20 | 0402R | RES | 1
4.7K | 电阻 | R25, R26, R27, R28 | 0402R | RES | 4
b5b35111e | 电路结构:单刀单掷; 按钮形状:矩形按钮; 作用力:1.8N;安装方 式:立贴;开关长 度:4.5mm;开关宽 度:1.9mm;开关高 度:3.5mm;带支架:带 支架;触点电流:50mA; 额定电压:12V;带灯: 无;工作寿命:5万次; | SW1 | SW-SMD_B5B35111E | b5b35111e | 1
esp32-s3-wroom-1-n8r2 | 核心芯片:ESP32-S3 芯片;频率:2.4GHz;天 线形式:板载PCB天 线;发射功 率:20.5dBm;接收灵敏 度:-98.2dBm; | U1 | WIRELM-SMD_ESP32-S3-WROOM-1 | esp32-s3-wroom-1-n8r2 | 1
TPS62A02 | TPS62A02 采用 SOT563 和 | U2 | SOT-563_L1.6-W1.2-P0.50-LS1.6-TL | TPS62A02 | 1
WB6058C | | U3 | TDFN-8_L3.0-W3.0-P0.65-BL-EP2.3 | WB6058C | 1
drv2605ldgst | DRV2605L 具有 2V 工作电压、波形库和 自动谐振跟踪功能的 ERM/LRA 触觉驱动 器 | U4 | VSSOP-10_L3.0-W3.0-P0.50-LS4.9-BL | drv2605ldgst | 1
as5600-asot | 旋转角度范围:0° ~360°; | U5 | SOIC-8_L5.0-W4.0-P1.27-LS6.0-BL | as5600-asot | 1
tmag5110c2aqdbvr | TMAG5110 高灵敏度 、2D、双通道、霍 尔效应锁存器 | U6 | SOT-23-5_L2.9-W1.6-P0.95-LS2.8-BR | tmag5110c2aqdbvr | 1
