dahongx/Oracle-OS/hardware/doc/屏幕/_extracted/CL28BC251-40A_IPS_RTP&WithoutTP_230801/CL28BC251-40A接线图.pdf

## 16位并口

## 8位并口

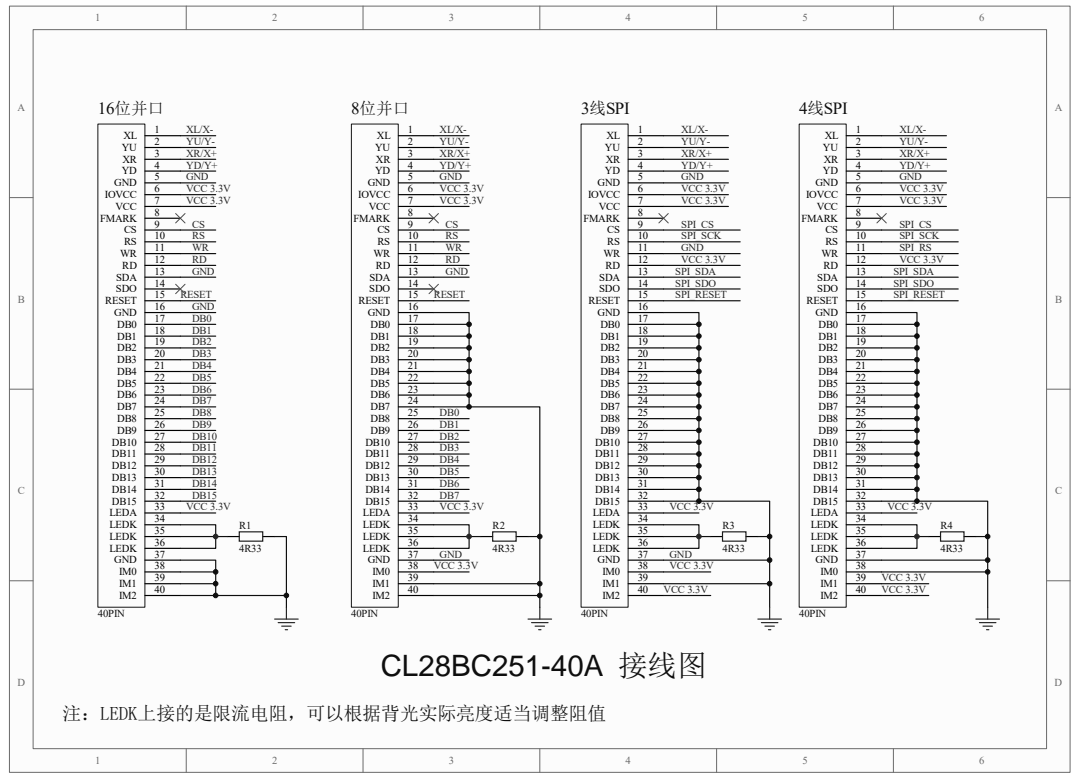
[picture p19: page 1]
RESET GND; GND; VCC 3.3V; IOVCC; VCC; FMARK; SDA; SDO; RESET; LEDA; LEDK; 40PIN; CS RS WR RD GND; DB0 DB1 DB2 DB3 DB4 DB5 DB6 DB7 DB8 DB9 DB10 DB11 DB12 DB13 DB14 DB15 VCC 3.3V; DB0 DB1 DB2 DB3 DB4 DB5 DB6 DB7 VCC 3.3V; GND VCC 3.3V; 3线SPI; SPI_SDO; SPI_SDA; SPI_CS; SPI_RESET; SPI_SCK; 4线SPI; SPI_RS; CL28BC251-40A 接线图; 注：LEDK上接的是限流电阻，可以根据背光实际亮度适当调整阻值
