dahongx/Oracle-OS/思迈微1.54寸-12P插接技术手册/1.54寸-12P-SPI原理图.pdf

接口定义： J1 J2 8 BLK 8 BLK 1.GND：电源地 7 CS 7 CS 2.VCC：电源正3.3V 6 DC 6 DC 5 RES 5 RES 4 SDA 4 SDA 3.SCL：SPI时钟 3 SCL 3 SCL 2 VCC 2 VCC 4.SDA：SPI数据 1 GND 1 GND 5.RES：复位 CON8 PH2_0_8P 6.DC：数据/命令控制 7.CS：SPI片选低电平有效 8.BLK：背光控制开关 | C1 GND GND1 1 0.1uF LEDK LEDK 2 VCC LEDA 3 VDD 4 GND GND2 5 GND3 6 DC D/C 7 CS CS 8 SCL SCL 9 SDA SDA 10 RES RES 11 GND GND4 12 IPS154-12

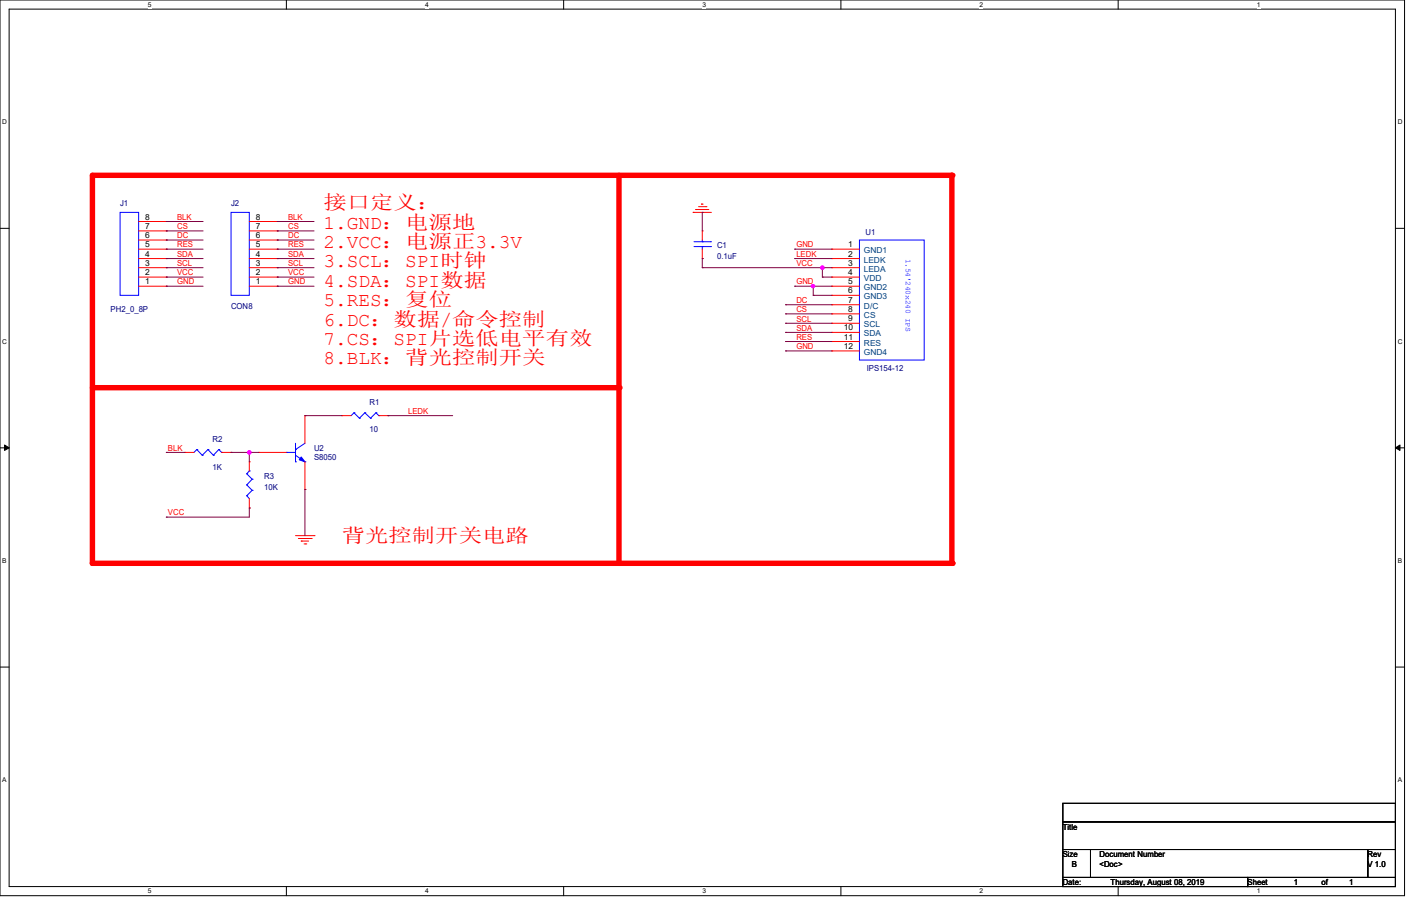
[picture p20: page 1]
背光控制开关电路; Title; Size; Document Number; Rev; Date:; Sheet; <Doc>; Thursday, August 08, 2019; 1.54'240x240 IPS; BLK; VCC

R1 LEDK
