dahongx/Oracle-OS/hardware/doc/屏幕/_extracted/CL28BC251-40A_IPS_RTP&WithoutTP_230801/测试程序/STC32_ST7789_IPS_16Bit  Demo_V1/USER/main.c

#include "lcd.h"   
#include "touch.h"  
#include "w25qx.h"
#include "test code.h"

//深圳市鸿讯电子有限公司
//TEL:13528896127
//创建日期:2023/3/30
//版本：V1.0
//单片机型号：STC32G12K128  3.3V

//=========================================电源接线================================================//
//VCC = DC 3.3V电源
//GND = 地

//=======================================液晶屏接线===========================================//
//数据总线类型为16位并口
// DB0~DB7   =        P0.0~P0.7      低8位数据线
// DB8~DB15  =        P2.0~P2.7      高8位数据线
// CS        =        P3.5           片选信号
// RS        =        P4.0           数据/命令选择控制信号
// WR        =        P3.6           写控制信号
// RD        =        P3.7           读控制信号
// RST       =        P3.4           复位信号
// LED       =        P3.3           背光开关控制

//=======================================电阻触摸接线==========================================//
//芯片：XPT2046
//TPEN  = P4.3  中断
//TSDO  = P4.1	数据输出
//TSDI  = P4.2  数据输入
//TCLK  = P4.5  时钟
//TCS   = P4.4	片选

//=======================================电容触摸接线==========================================//
//芯片：FT6336
//FT_INT  		= P4.3  中断
//CT_IIC_SDA  = P4.2  数据 输出\输入
//CT_IIC_SCL  = P4.5  时钟
//FT_RST 		  = P4.4	复位

//=======================================FLASH接线==========================================//
//芯片：W25Q32FVSIG
//F_CS     = P5.3  片选
//F_SCLK   = P5.1  时钟      
//F_DIO    = P5.0  数据输入
//DO_Read  = P5.2  数据输出

//=============================================================================================//

/////////////////////////////////////用户配置区 在LCD.h文件///////////////////////////////////	 
//#define USE_LCM_DIR  	  0   	//定义液晶屏顺时针旋转方向 	0-0度旋转，1-180度旋转，2-270度旋转，3-90度旋转
//#define USE_TP_TYPE   	RTP 	//定义触摸类型  CTP = 电容模式 , RTP = 电阻模式


void main(void)
{
 	WTST = 0;                           //设置程序指令延时参数，赋值为0可将CPU执行指令的速度设置为最快
  EAXFR = 1;                          //扩展寄存器(XFR)访问使能
  CKCON = 0;                          //提高访问XRAM速度
  LCD_LED = 0;                        //背光默认关闭  
	Set_GPIO();                         //端口设置
	LCD_Init();			                    //初始化LCD 	
  tp_dev.touchtype|=USE_TP_TYPE;			//电容触摸&电阻触摸
  LCD_Display_Dir(USE_LCM_DIR);		 		//屏幕方向
	LCD_Clear(WHITE);                   //清屏
	LCD_LED=1;					                //点亮背光	

	
	main_test("IC:ST7789");		  //测试主页
	Color_Test();								//纯色测试
	Read_Test();								//读ID 颜色 测试
	FillRec_Test();							//图形测试
	English_Font_test();				//英文测试
	Chinese_Font_test();				//中文测试
	Pic_test();									//图片测试
	Switch_test();							//显示开关测试
	Rotate_Test();							//角度测试

	//不需要触摸请注释掉以下代码
	LCD_Display_Dir(0);					//屏幕切换为竖屏状态
	tp_dev.init();							//触摸屏初始化
 	POINT_COLOR=RED;						//设置字体为红色 

	Load_Drow_Dialog();	 	
	if(tp_dev.touchtype&0X80)ctp_test();	//电容屏测试
	else rtp_test(); 											//电阻屏测试
}
