dahongx/Oracle-OS/hardware/doc/屏幕/_extracted/CL28BC251-40A_IPS_RTP&WithoutTP_230801/测试程序/STM32F1_ST7789_IPS_16Bit  Demo_V1/HARDWARE/LCD/LCD.h

#ifndef __LCD_H
#define __LCD_H		
#include "sys.h"	 

	 
/////////////////////////////////////用户配置区///////////////////////////////////	 
//支持横竖屏快速定义切换
#define USE_LCM_DIR  	  0   	//定义液晶屏顺时针旋转方向 	0-0度旋转，1-180度旋转，2-270度旋转，3-90度旋转
#define USE_TP_TYPE   	RTP 	//定义触摸类型  CTP = 电容模式 , RTP = 电阻模式

#define CTP 0X80		//电容模式
#define RTP 0X00		//电阻模式	 
	 
	 
//LCD重要参数集
typedef struct  
{										    
	u16 width;			//LCD 宽度
	u16 height;			//LCD 高度
	u16 id;				//LCD ID
	u8  dir;			//横屏还是竖屏控制：0，竖屏；1，横屏。	
	u16	wramcmd;		//开始写gram指令
	u16 setxcmd;		//设置x坐标指令
	u16  setycmd;		//设置y坐标指令	 
}_lcd_dev; 	  

//LCD参数
extern _lcd_dev lcddev;	//管理LCD重要参数
//LCD的画笔颜色和背景色	   
extern u16  POINT_COLOR;//默认红色    
extern u16  BACK_COLOR; //背景颜色.默认为白色

////////////////////////////////////////////////////////////////////
//-----------------LCD端口定义---------------- 

#define	LCD_RST_SET  GPIOC->BSRR=1<<15    //复位  	    	 PC15
#define	LCD_CS_SET  GPIOA->BSRR=1<<12    //片选端口  	     PA12
#define	LCD_RS_SET	GPIOA->BSRR=1<<15    //数据/命令       PA15	   
#define	LCD_WR_SET	GPIOC->BSRR=1<<13    //写数据					 PC13
#define	LCD_RD_SET	GPIOC->BSRR=1<<14    //读数据					 PC14

#define	LCD_RST_CLR  GPIOC->BRR=1<<15    //复位  	    		 PC15
#define	LCD_CS_CLR  GPIOA->BRR=1<<12     //片选端口  	     PA12
#define	LCD_RS_CLR	GPIOA->BRR=1<<15     //数据/命令       PA15   
#define	LCD_WR_CLR	GPIOC->BRR=1<<13     //写数据					 PC13
#define	LCD_RD_CLR	GPIOC->BRR=1<<14     //读数据					 PC14  	

#define	LCD_LED PAout(2) //背光 开关

//PB0~15,作为数据线
#define DATAOUT(x) GPIOB->ODR=x; //数据输出
#define DATAIN     GPIOB->IDR;   //数据输入		
	 

//画笔颜色
#define WHITE         	 0xFFFF
#define BLACK         	 0x0000	  
#define BLUE         	 0x001F  
#define BRED             0XF81F
#define GRED 			 0XFFE0
#define GBLUE			 0X07FF
#define RED           	 0xF800
#define MAGENTA       	 0xF81F
#define GREEN         	 0x07E0
#define CYAN          	 0x7FFF
#define YELLOW        	 0xFFE0
#define BROWN 			 0XBC40 //棕色
#define BRRED 			 0XFC07 //棕红色
#define GRAY  			 0X8430 //灰色
//GUI颜色

#define DARKBLUE      	 0X01CF	//深蓝色
#define LIGHTBLUE      	 0X7D7C	//浅蓝色  
#define GRAYBLUE       	 0X5458 //灰蓝色
//以上三色为PANEL的颜色 
 
#define LIGHTGREEN     	 0X841F //浅绿色 
#define LGRAY 					 0XC618 //浅灰色(PANNEL),窗体背景色

#define LGRAYBLUE        0XA651 //浅灰蓝色(中间层颜色)
#define LBBLUE           0X2B12 //浅棕蓝色(选择条目的反色)
	    															  
	    															  
void LCD_Init(void);													   	//初始化
void LCD_DisplayOn(void);													//开显示
void LCD_DisplayOff(void);													//关显示
void LCD_Clear(u16 Color);	 												//清屏
void LCD_SetCursor(u16 Xpos, u16 Ypos);										//设置光标
void LCD_DrawPoint(u16 x,u16 y);											//画点
void LCD_Fast_DrawPoint(u16 x,u16 y,u16 color);								//快速画点
void LCD_Draw_Circle(u16 x0,u16 y0,u8 r);						 			//画圆
void LCD_DrawLine(u16 x1, u16 y1, u16 x2, u16 y2);							//画线
void LCD_DrawRectangle(u16 x1, u16 y1, u16 x2, u16 y2);		   				//画矩形
void LCD_Fill(u16 sx,u16 sy,u16 ex,u16 ey,u16 color);		   				//填充单色
void LCD_Color_Fill(u16 sx,u16 sy,u16 ex,u16 ey,u16 *color);				//填充指定颜色
void LCD_ShowChar(u16 x,u16 y,u8 num,u8 size,u8 mode);						//显示一个字符
void LCD_ShowNum(u16 x,u16 y,u32 num,u8 len,u8 size);  						//显示一个数字
void LCD_ShowxNum(u16 x,u16 y,u32 num,u8 len,u8 size,u8 mode);				//显示 数字
void LCD_ShowString(u16 x,u16 y,u16 width,u16 height,u8 size,u8 *p);		//显示一个字符串,12/16字体

void LCD_WriteReg(u16 LCD_Reg, u16 LCD_RegValue);
void LCD_WriteRAM_Prepare(void);
void LCD_WriteRAM(u16 RGB_Code);
void Load_Drow_Dialog(void);
void LCD_Set_Window(u16 sx,u16 sy,u16 width,u16 height);	//设置窗口				
void Show_Str(u16 x, u16 y,u8 *str,u8 size,u8 mode);//显示中文
void Gui_Drawbmp16(u16 x,u16 y,const unsigned char *p); //显示40*40 图片
void Gui_StrCenter(u16 x, u16 y,u8 *str,u8 size,u8 mode);//居中显示
void LCD_Display_Dir(u8 dir); //设置LCD显示方向
void lcd_draw_bline(u16 x1, u16 y1, u16 x2, u16 y2,u8 size,u16 color);//画一条粗线
void gui_fill_circle(u16 x0,u16 y0,u16 r,u16 color);//画实心圆
void gui_draw_hline(u16 x0,u16 y0,u16 len,u16 color);//画水平线 电容触摸屏专有部分
u16 LCD_Read_ID(u8 reg);//读ID
u16 LCD_ReadPoint(u16 x,u16 y);//读取指定坐标颜色



#endif
