dahongx/Oracle-OS/hardware/doc/屏幕/_extracted/CL28BC251-40A_IPS_RTP&WithoutTP_230801/测试程序/STC32_ST7789_IPS_16Bit  Demo_V1/HARDWARE/LCD/pic.h

#ifndef __PIC_H
#define __PIC_H 

//16位BMP 40X40 图像取模数据
//Image2LCD取模选项设置
//水平扫描
//16位
//40X40
//不包含图像头数据
//自左至右
//自顶至底
//低位在前
unsigned char code gImage_1[3200] = { /* 0X00,0X10,0X28,0X00,0X28,0X00,0X01,0X1B, */
0XBE,0XF7,0XBE,0XF7,0XBE,0XF7,0XBE,0XF7,0XBE,0XF7,0XBE,0XF7,0XBE,0XF7,0XBE,0XF7,
0XBE,0XF7,0XBE,0XF7,0XBE,0XF7,0XBE,0XF7,0XBE,0XF7,0XBE,0XF7,0XBE,0XF7,0XBE,0XF7,
0XBE,0XF7,0XBE,0XF7,0XDF,0XF7,0X7D,0XF7,0XAF,0XDB,0XFF,0XF7,0XFF,0XF7,0XBE,0XF7,
0XBE,0XF7,0XBE,0XF7,0XBE,0XF7,0XBE,0XF7,0XBE,0XF7,0XBE,0XF7,0XBE,0XF7,0XBE,0XF7,
0XBE,0XF7,0XBE,0XF7,0XBE,0XF7,0XBE,0XF7,0XBE,0XF7,0XBE,0XF7,0XBE,0XF7,0XBE,0XF7,
0XBE,0XF7,0XBE,0XF7,0XBE,0XF7,0XBE,0XF7,0XBE,0XF7,0XBE,0XF7,0XBE,0XF7,0XBE,0XF7,
0XBE,0XF7,0XBE,0XF7,0XBE,0XF7,0XBE,0XF7,0XBE,0XF7,0XBE,0XF7,0XBE,0XF7,0XBE,0XF7,
0XBE,0XF7,0XBE,0XF7,0XBE,0XF7,0XFF,0XF7,0X39,0XEE,0X00,0XD0,0XB3,0XE4,0XFF,0XFF,
0XDE,0XF7,0XBE,0XF7,0XBE,0XF7,0XBE,0XF7,0XBE,0XF7,0XBE,0XF7,0XBE,0XF7,0XBE,0XF7,
0XBE,0XF7,0XBE,0XF7,0XBE,0XF7,0XBE,0XF7,0XBE,0XF7,0XBE,0XF7,0XBE,0XF7,0XBE,0XF7,
0XBE,0XF7,0XBE,0XF7,0XBE,0XF7,0XBE,0XF7,0XBE,0XF7,0XBE,0XF7,0XBE,0XF7,0XBE,0XF7,
0XBE,0XF7,0XBE,0XF7,0XBE,0XF7,0XBE,0XF7,0XBE,0XF7,0XBE,0XF7,0XDF,0XF7,0XBE,0XF7,
0XBE,0XF7,0XBE,0XF7,0XBE,0XF7,0XBE,0XF7,0XFF,0XFF,0XAB,0XE2,0X00,0XD8,0X88,0XD9,
0XFF,0XFF,0XDF,0XF7,0XBE,0XF7,0XBE,0XF7,0XBE,0XF7,0XBE,0XF7,0XBE,0XF7,0XBE,0XF7,
0XBE,0XF7,0XBE,0XF7,0XBE,0XF7,0XBE,0XF7,0XBE,0XF7,0XBE,0XF7,0XBE,0XF7,0XBE,0XF7,
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
0XFF,0XFF,0XFF,0XFF,0XFF,0XFF,0XFF,0XFF,0XFF,0XFF,0XFF,0XFF,0XFF,0XFF,0XDF,0XFF,
0XBE,0XF7,0XBE,0XF7,0XBE,0XF7,0XBE,0XF7,0XBE,0XF7,0XBE,0XF7,0XBE,0XF7,0XBE,0XF7,
0XBE,0XF7,0XBE,0XF7,0XBE,0XF7,0XBE,0XF7,0XBE,0XF7,0XBE,0XF7,0XBE,0XF7,0XBE,0XF7,
};
#endif
